eugenyh/voxshare_device/Common_view2.jpg

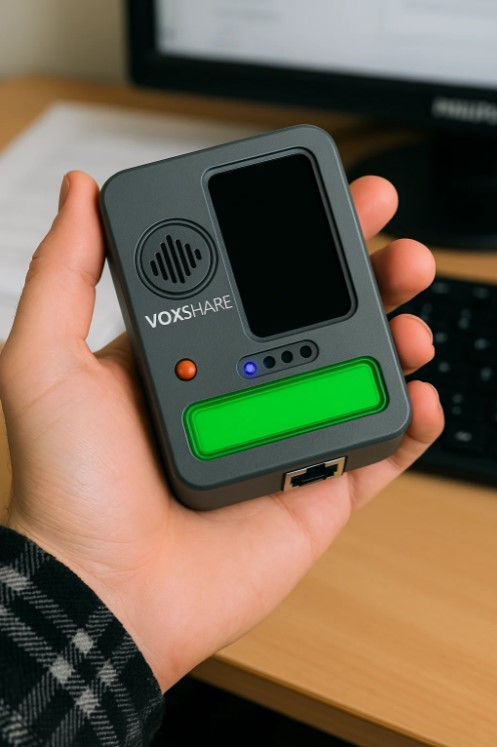
Common_view2.jpg
