eugenyh/voxshare_device/Firmware/voxshare_esp/connections.jpg

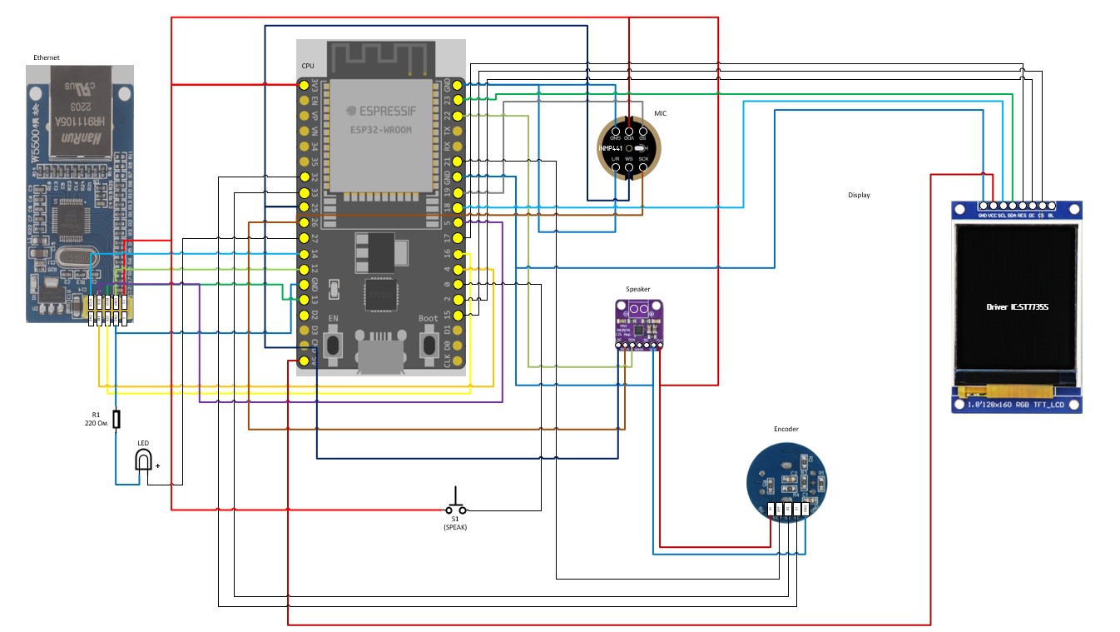
Firmware/voxshare_esp/connections.jpg
