eugenyh/voxshare_device/EasyEDA_project/HW01/BOM_VS_Board_VS_PCB_2025-07-08.xlsx

No. | Quantity | Comment | Designator | Footprint | Value | Manufacturer Part | Manufacturer | Supplier Part | Supplier
1 | 1 | 1N4148 | D1 | DO-35_BD2.0-L4.2-P8.20-D0.5-RD |  | 1N4148 | GOOD-ARK(固锝) | C406389 | LCSC
2 | 1 | DC005-T25 | DC1 | DC-IN-TH_DC-005-20A-1 |  | DC005-T25 | SOFNG(硕方) | C111573 | LCSC
3 | 2 | PM254-1-19-Z-8.5 | H1,H2 | HDR-TH_19P-P2.54-V-F |  | PM254-1-19-Z-8.5 | HCTL(华灿天禄) | C2897382 | LCSC
4 | 1 | B-2200S07P-A120 | H3 | HDR-TH_7P-P2.54-V-F |  | B-2200S07P-A120 | Ckmtw(灿科盟) | C124418 | LCSC
5 | 1 | G5V-1 DC5 | K1 | RELAY-TH_G5V-1 |  | G5V-1 DC5 | OMRON(欧姆龙) | C28695 | LCSC
6 | 1 | 2N7002 | Q1 | SOT-23-3_L2.9-W1.3-P1.90-LS2.4-BR |  | 2N7002 | YFW(佑风微) | C42395051 | LCSC
7 | 1 | 220Ω | R1 | R0603 | 220Ω | 0603WAF2200T5E | UNI-ROYAL(厚声) | C22962 | LCSC
8 | 1 | 10kΩ | R3 | R0603 | 10kΩ | SCR0603J10K | VO(翔胜) | C3017715 | LCSC
9 | 1 | 100kΩ | R4 | R0603 | 100kΩ | FCR0603F100K | VO(翔胜) | C5913165 | LCSC
10 | 1 | TS-1003S-05026 | SW1 | KEY-SMD_4P-L12.0-W12.0-P5.00-LS15.2 |  | TS-1003S-05026 | XUNPU(讯普) | C455219 | LCSC
11 | 1 | PM254-2-05-Z-8.5 | U1 | HDR-TH_10P-P2.54-V-F-R2-C5-S2.54 |  | PM254-2-05-Z-8.5 | HCTL(华灿天禄) | C2897406 | LCSC
12 | 4 | PM254-1-02-Z-8.5 | U2,U3,U4,U5 | HDR-TH_2P-P2.54-V-F |  | PM254-1-02-Z-8.5 | HCTL(华灿天禄) | C2897365 | LCSC
13 | 1 | PM254-1-08-Z-8.5 | U6 | HDR-TH_8P-P2.54-V-F |  | PM254-1-08-Z-8.5 | HCTL(华灿天禄) | C2897371 | LCSC
14 | 2 | PM254-1-03-Z-8.5 | U7,U8 | HDR-TH_3P-P2.54-V-F |  | PM254-1-03-Z-8.5 | HCTL(华灿天禄) | C2897366 | LCSC
15 | 1 | TJ-L5FPTGCRMFCSFLC2R-A5 | U9 | LED-TH_BD5.8-P2.54-FD |  | TJ-L5FPTGCRMFCSFLC2R-A5 | TOGIALED(统佳) | C331030 | LCSC
16 | 1 | KF301-5.0-2P | U10 | CONN-TH_P5.00_KF301-5.0-2P |  | KF301-5.0-2P | KEFA(科发) | C474881 | LCSC
