eugenyh/voxshare_device/(list of files, cad)

Other CAD files:
3DCase/VoxShareCase.skp
