eugenyh/voxshare_device/EasyEDA_project/HW01/schematic.pdf

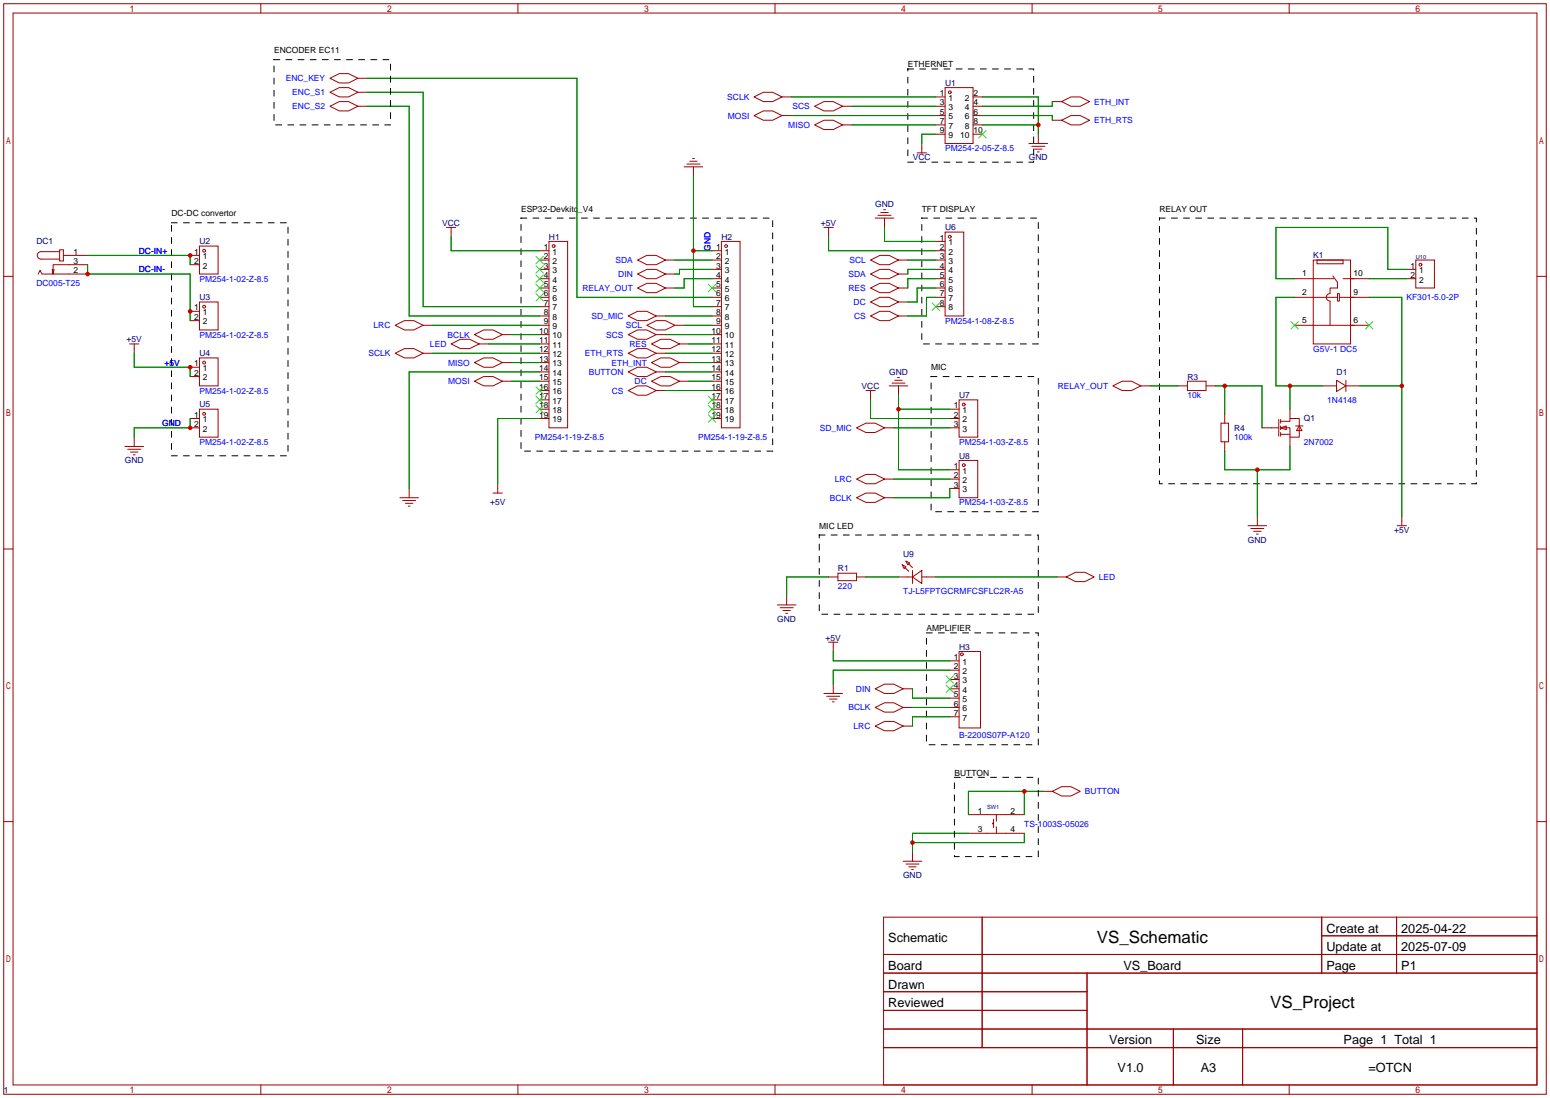
[picture p4: page 1]

TFT DISPLAY DC-DC convertor

Schematic | VS_Schematic | Create at | 2025-04-22

Update at | 2025-07-09

Board | VS_Board | Page | P1
Drawn | | VS_Project
Reviewed

Version | Size | Page 1 Total 1
V1.0 | A3 | =OTCN
