eugenyh/voxshare_device/(list of files, drawings)

Other design files:
EasyEDA_project/HW01/VS_Project_HW01.eprj
EasyEDA_project/HW02/VS_Project_HW02.eprj
EasyEDA_project/HW03M/VS_Module.eprj
