eugenyh/voxshare_device/Firmware/voxshare_esp/main/init_sound.h

#ifndef INIT_SOUND_H
#define INIT_SOUND_H

const int32_t init_sound[] = {
    0x00000000, 0x00000000, 0x00000000, 0x00000000, 0x00000100, 0xFFFFFE00,
    0x00000200, 0xFFFFFE00, 0x00000100, 0x00000000, 0x00000100, 0xFFFFFD00,
    0x00000300, 0xFFFFFE00, 0x00000100, 0x00000000, 0xFFFFFF00, 0x00000100,
    0x00000000, 0x00000000, 0x00000000, 0x00000000, 0xFFFFFF00, 0x00000200,
    0xFFFFFE00, 0x00000200, 0xFFFFFF00, 0xFFFFFF00, 0x00000100, 0x00000000,
    0xFFFFFF00, 0x00000200, 0xFFFFFE00, 0x00000000, 0x00000200, 0xFFFFFE00,
    0x00000100, 0x00000000, 0xFFFFFF00, 0x00000100, 0x00000000, 0x00000000,
    0xFFFFFF00, 0x00000100, 0x00000000, 0xFFFFFF00, 0x00000200, 0xFFFFFD00,
    0x00000200, 0x00000000, 0xFFFFFF00, 0x00000200, 0xFFFFFD00, 0x00000200,
    0x00000000, 0xFFFFFF00, 0x00000200, 0xFFFFFD00, 0x00000300, 0xFFFFFD00,
    0x00000300, 0xFFFFFE00, 0x00000100, 0x00000000, 0xFFFFFE00, 0x00000300,
    0xFFFFFE00, 0x00000100, 0x00000100, 0xFFFFFD00, 0x00000300, 0xFFFFFE00,
    0x00000100, 0x00000100, 0xFFFFFE00, 0x00000200, 0xFFFFFE00, 0x00000200,
    0xFFFFFE00, 0x00000200, 0xFFFFFE00, 0x00000200, 0xFFFFFE00, 0x00000200,
    0xFFFFFE00, 0x00000200, 0xFFFFFE00, 0x00000100, 0x00000100, 0xFFFFFE00,
    0x00000100, 0xFFFFFF00, 0x00000200, 0xFFFFFD00, 0x00000400, 0xFFFFFB00,
    0x00000500, 0xFFFFFC00, 0x00000200, 0xFFFFFF00, 0x00000100, 0x00000000,
    0xFFFFFF00, 0x00000100, 0xFFFFFF00, 0x00000100, 0x00000000, 0xFFFFFF00,
    0x00000100, 0xFFFFFF00, 0x00000100, 0x00000000, 0xFFFFFF00, 0x00000100,
    0xFFFFFF00, 0x00000100, 0x00000000, 0x00000000, 0xFFFFFF00, 0x00000100,
    0xFFFFFF00, 0x00000200, 0xFFFFFD00, 0x00000400, 0xFFFFFB00, 0x00000400,
    0xFFFFFE00, 0x00000100, 0xFFFFFF00, 0x00000200, 0xFFFFFD00, 0x00000300,
    0xFFFFFF00, 0xFFFFFF00, 0x00000100, 0x00000000, 0x00000000, 0x00000000,
    0xFFFFFF00, 0x00000200, 0xFFFFFD00, 0x00000400, 0xFFFFFC00, 0x00000200,
    0x00000000, 0x00000000, 0x00000000, 0x00000000, 0xFFFFFF00, 0x00000200,
    0xFFFFFF00, 0x00000000, 0x00000000, 0xFFFFFF00, 0x00000200, 0xFFFFFF00,
    0x00000000, 0x00000000, 0x00000000, 0x00000000, 0x00000000, 0x00000000,
    0x00000000, 0x00000000, 0x00000100, 0xFFFFFE00, 0x00000200, 0xFFFFFE00,
    0x00000200, 0xFFFFFE00, 0x00000200, 0xFFFFFF00, 0xFFFFFF00, 0x00000200,
    0xFFFFFE00, 0x00000200, 0xFFFFFF00, 0xFFFFFF00, 0x00000200, 0xFFFFFD00,
    0x00000400, 0xFFFFFC00, 0x00000300, 0xFFFFFF00, 0xFFFFFF00, 0x00000200,
    0xFFFFFD00, 0x00000300, 0xFFFFFE00, 0x00000100, 0x00000000, 0xFFFFFF00,
    0x00000100, 0xFFFFFF00, 0x00000100, 0x00000000, 0xFFFFFF00, 0x00000100,
    0xFFFFFF00, 0x00000100, 0x00000000, 0xFFFFFE00, 0x00000300, 0xFFFFFC00,
    0x00000500, 0xFFFFFB00, 0x00000400, 0xFFFFFC00, 0x00000400, 0xFFFFFD00,
    0x00000300, 0xFFFFFD00, 0x00000200, 0xFFFFFE00, 0x00000300, 0xFFFFFD00,
    0x00000300, 0xFFFFFE00, 0x00000000, 0x00000100, 0xFFFFFF00, 0x00000000,
    0x00000100, 0xFFFFFE00, 0x00000200, 0xFFFFFF00, 0x00000000, 0x00000100,
    0xFFFFFE00, 0x00000200, 0xFFFFFF00, 0x00000000, 0x00000100, 0xFFFFFE00,
    0x00000300, 0xFFFFFC00, 0x00000500, 0xFFFFFB00, 0x00000400, 0xFFFFFC00,
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
};
const unsigned int init_sound_length = 4991;

#endif
