eugenyh/voxshare_device/(commit log)

2025-04-21 3D model and visual update
    [VoxShareCase.skp]
2025-04-22 Create New Project_2025-04-22_09-05-46.eprj
    [New Project_2025-04-22_09-05-46.eprj]
2025-04-22 EasyEDA setup
    [New Project_2025-04-22_09-05-46.eprj, VS_Project.eprj]
2025-04-25 Update 3D case
    [VoxShareCase.skp]
2025-04-25 Append dc port
    [VoxShareCase.skp]
2025-06-30 Append encoder component
2025-07-01 Audio processing minor bugs
    [main.c]
2025-08-08 pcb update
    [BOM_VS_Board_VS_PCB_2025-07-08.xlsx, BOM_VS_Board_VS_PCB_2025-07-11.xlsx, PickAndPlace_VS_PCB_2025-07-08.xlsx, PickAndPlace_VS_PCB_2025-07-11.xlsx, VS_Module.eprj, VS_Project.eprj, VS_Project_HW01.eprj, VS_Project_HW02.eprj]
